Denny-Hwang/TENG_SLT/docs/IMG_1770.jpeg

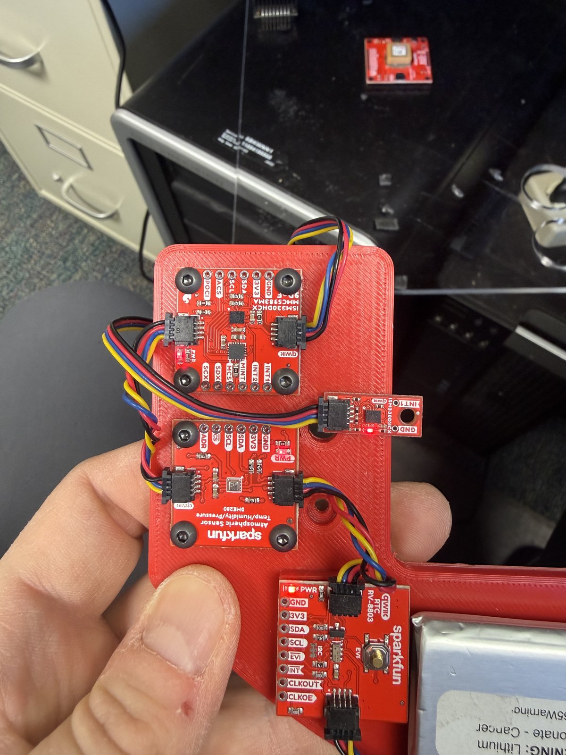
docs/IMG_1770.jpeg
