Denny-Hwang/TENG_SLT/docs/Ground_RFD900x.png

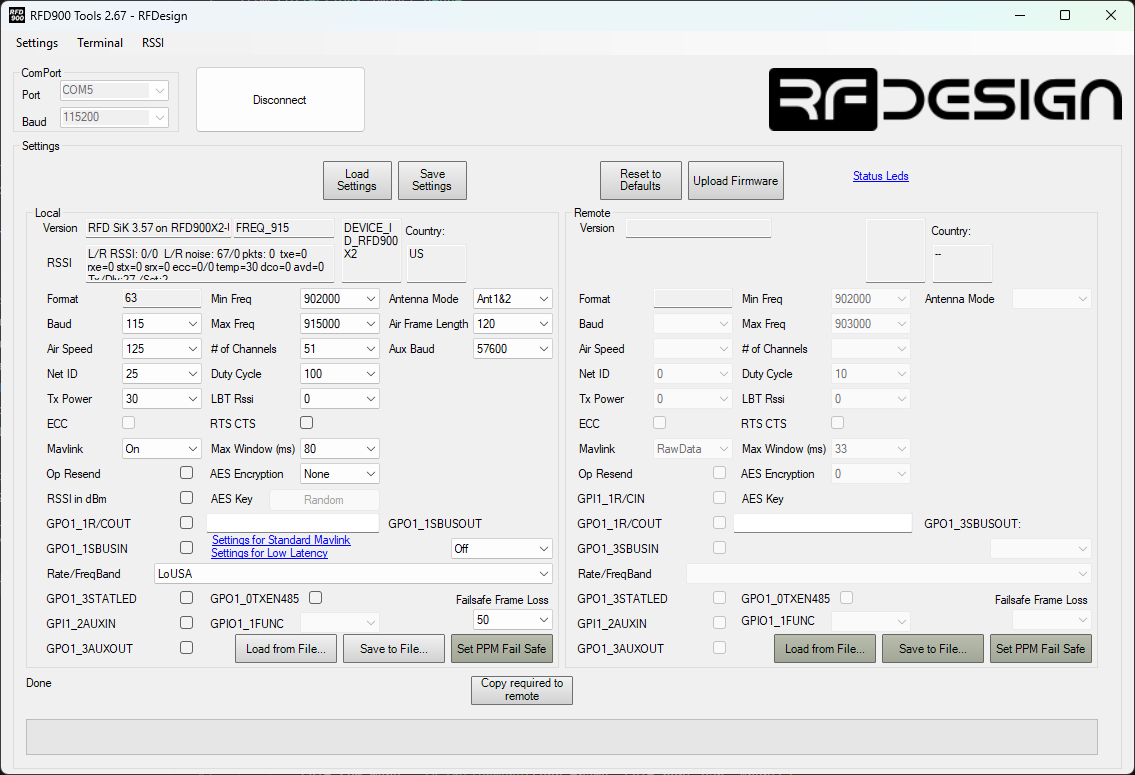
docs/Ground_RFD900x.png
