Denny-Hwang/TENG_SLT/docs/Screenshot 2026-04-22 175744.png

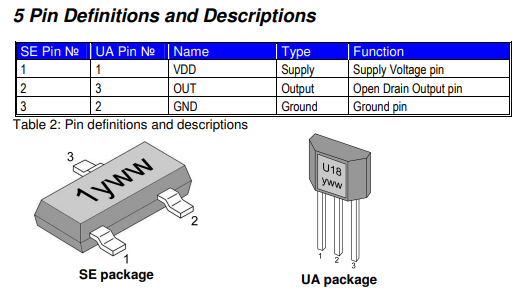
docs/Screenshot 2026-04-22 175744.png
