Denny-Hwang/TENG_SLT/docs/vertisea_system_diagram.png

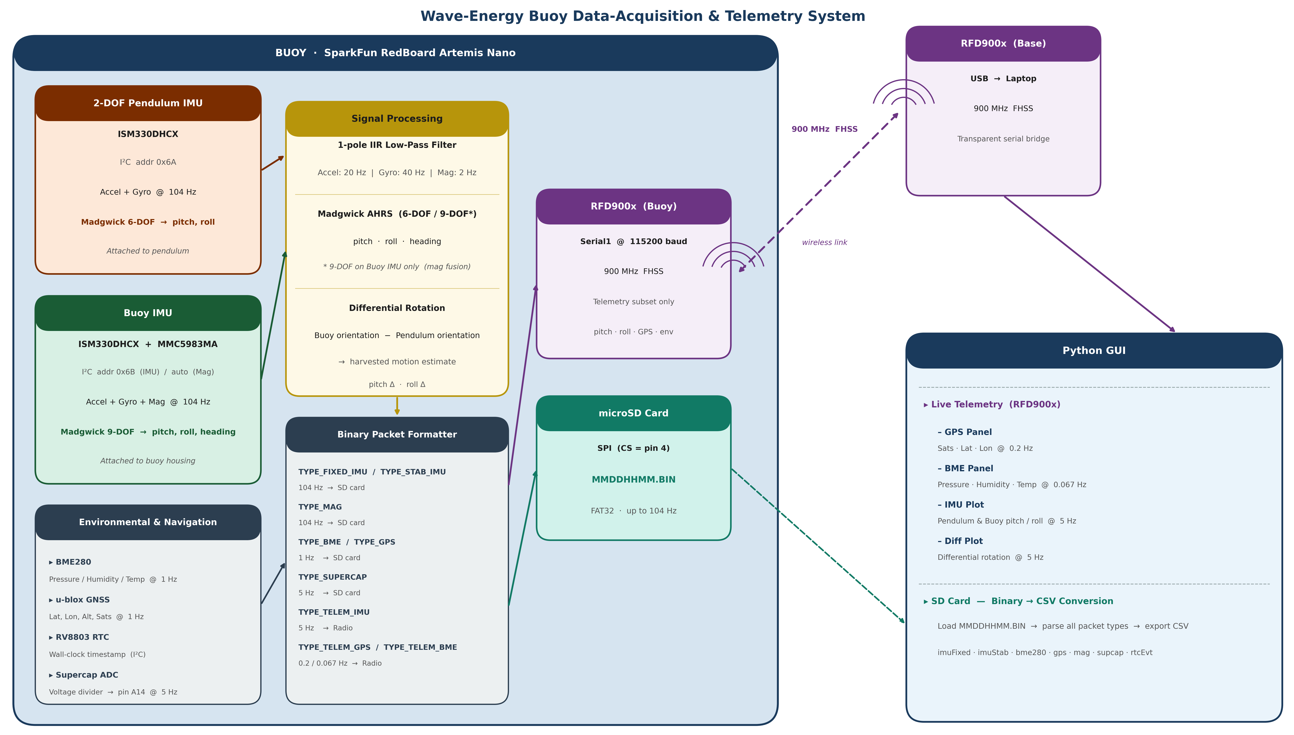
docs/vertisea_system_diagram.png
