Denny-Hwang/TENG_SLT/Calibration/accel_calibration_meas.txt

Fixed
X_bias = (1008 + -1001)/2 = 3.5
X_scale = (1008 - -1001)/2 = 1004.5

Y_bias = (982 + -1032)/2 = -25
Y_scale = (982 - -1032)/2 = 1007

Z_bias = (1009 + -989)/2 = 10
Z_scale = (1009 - -989)/2 = 999

Stab
X_bias = (998 + -1004)/2 = -3
X_scale = (998 - -1004)/2 = 1001

Y_bias =  (979 + -1009)/2 = -15
Y_scale = (979 - -1009)/2 = 994

Z_bias = (1026 + -981)/2 = 22.5
Z_scale = (1026 - -981)/2 = 1003.5
