Denny-Hwang/TENG_SLT/Calibration/calibration.xlsx

Sheet: Sheet1
min | max
-1005.5 | 998 | 1001.75 | -3.75
-1014 | 978.5 | 996.25 | -17.75
-978.5 | 1029.5 | 1004 | 25.5

Sheet: Sheet1 (2)
min | max
-1001.5 | 1006.5 | 1004 | 2.5
-1031.5 | 984 | 1007.75 | -23.75
-985 | 1008 | 996.5 | 11.5
