Denny-Hwang/TENG_SLT/docs/CHANGELOG_vertisea_explorer.py.md

# Explorer Changelog

## 2026-10-17 - Offline Tk explorer - [UNCONFIRMED]

Added standalone Toplevel explorer, paged native and aligned sheets with both
scrollbars, multi-table numeric selection, boot/source/time filters, shared-x
separate-axis plots and streamed CSV export. Worker-owned read-only handles keep
Tk responsive without sharing a live recorder handle. Active recorder guard,
rolling display and explicit estimated power avoid silent scientific claims.
Synthetic Tk tests cover resize, plots, export, invalid inputs and GUI launch.
