Denny-Hwang/TENG_SLT/tests/test_binary_protocol.py

#!/usr/bin/env python3
"""Round-trip tests for the VertiSea SD binary protocol.

WHY THIS EXISTS
---------------
`vertisea_plot_v7.py` is the *only* reader of the SD log format. Every packet layout is
duplicated by hand in two places — the packed structs in `VertiSea/VertiSea.ino` and the
`struct.unpack` format strings here — with nothing but discipline keeping them aligned.
A silent divergence corrupts every CSV produced from that point on, and the corruption is
not obvious: a wrong field width shifts subsequent columns into plausible-looking numbers.

So this file builds `.BIN` byte streams from the layouts documented in
`docs/binary_protocol.md`, feeds them through `parse_binary_file()`, and asserts the values
come back unchanged. It is a *writer* independent of the parser: if the parser's field
order or width drifts, the assertion fails.

WHAT IT DOES NOT PROVE
----------------------
That the firmware emits these bytes. Nothing here compiles or runs the sketch, so a change
made to `VertiSea.ino` alone will not fail these tests — they pin the parser against the
protocol document, not against the firmware. Issue 35 is the standing reminder that a
round-trip test proves the *transport* is right and says nothing about whether the chosen
types can hold real values: an int16 gyro field round-tripped perfectly and still wrapped
sign on hardware. Check a real log against physical expectations too.

USAGE
-----
    python3 tests/test_binary_protocol.py        # stdlib only, no pytest required
    python3 -m pytest tests/test_binary_protocol.py -q    # also works under pytest
"""

import csv
import os
import struct
import sys
import tempfile
import unittest

sys.path.insert(0, os.path.dirname(os.path.dirname(os.path.abspath(__file__))))

import vertisea_protocol as vs  # noqa: E402


# ---------------------------------------------------------------------------
# Record writers — independent of the parser, built from docs/binary_protocol.md
# ---------------------------------------------------------------------------

def record(pkt_type: int, ts_ms: int, payload: bytes) -> bytes:
    """The 5-byte common header (uint8 type + uint32 little-endian ms) plus payload."""
    return struct.pack('<BI', pkt_type, ts_ms) + payload


def imu_raw(ts_ms, fix_a, fix_g, stab_a, stab_g, interval_us) -> bytes:
    """0x12 — '<3h3i3h3iH', 38-byte payload."""
    return record(vs.TYPE_IMU_RAW, ts_ms,
                  struct.pack('<3h3i3h3iH', *fix_a, *fix_g, *stab_a, *stab_g, interval_us))


def current_block(ts_ms, span_ms, samples) -> bytes:
    """0x0E — uint16 span_ms, uint16 count, count x uint16. Variable length."""
    return record(vs.TYPE_CURRENT_BLOCK, ts_ms,
                  struct.pack('<HH', span_ms, len(samples))
                  + struct.pack(f'<{len(samples)}H', *samples))


def hall_edge(ts_ms, edges_us) -> bytes:
    """0x11 — uint8 count, count x uint32 micros(). Variable length."""
    return record(vs.TYPE_HALL_EDGE, ts_ms,
                  struct.pack('<B', len(edges_us))
                  + struct.pack(f'<{len(edges_us)}I', *edges_us))


def sys_health(ts_ms, loop_max_us=3000, sd_write_max_us=1200, sd_write_failures=0,
               sd_recoveries=0, hall_rejected=0, hall_lost=0,
               sd_queue_high_water=512, sd_overruns=0, flags=0) -> bytes:
    """0x15 — '<6I2HB', 29-byte payload."""
    return record(vs.TYPE_SYS_HEALTH, ts_ms,
                  struct.pack('<6I2HB', loop_max_us, sd_write_max_us,
                              sd_write_failures, sd_recoveries, hall_rejected,
                              hall_lost, sd_queue_high_water, sd_overruns, flags))


def current_cal(ts_ms, vref, adc_max, div_ratio, sens) -> bytes:
    return record(vs.TYPE_CURRENT_CAL, ts_ms,
                  struct.pack('<4f', vref, adc_max, div_ratio, sens))


def battery_cal(ts_ms, vref, adc_max, r_top, r_bottom, ratio) -> bytes:
    return record(vs.TYPE_BATTERY_CAL, ts_ms,
                  struct.pack('<5f', vref, adc_max, r_top, r_bottom, ratio))


# `data['errors']` mixes two different things: structural failures that stop the parse
# (truncated record, unknown type) and advisory warnings about an otherwise-fine log
# (no calibration record, so the derived column stays blank). Most tests care only about
# the former, so they assert on this filtered view rather than on an empty list.
_STRUCTURAL = ('Truncated', 'Unknown packet type', 'Skipped known-type')


def structural_errors(data: dict) -> list:
    return [e for e in data['errors'] if any(k in e for k in _STRUCTURAL)]


def parse_bytes(blob: bytes) -> dict:
    """Write `blob` to a temp .BIN and run the production parser over it."""
    fd, path = tempfile.mkstemp(suffix='.BIN')
    try:
        with os.fdopen(fd, 'wb') as f:
            f.write(blob)
        return vs.parse_binary_file(path)
    finally:
        os.unlink(path)


# ---------------------------------------------------------------------------


class TestFixedLayouts(unittest.TestCase):
    """Every fixed-size packet survives a write/parse round trip."""

    def test_imu_raw_round_trip(self):
        data = parse_bytes(imu_raw(
            12345,
            fix_a=(-1000, 2000, 980), fix_g=(-250000, 250000, 1),
            stab_a=(11, -22, 1001), stab_g=(7, -8, 9),
            interval_us=10780))
        self.assertEqual(data['errors'], [])
        self.assertEqual(len(data['imu_raw']), 1)
        r = data['imu_raw'][0]
        self.assertEqual(r['ts_ms'], 12345)
        self.assertEqual((r['fix_ax_mg'], r['fix_ay_mg'], r['fix_az_mg']), (-1000, 2000, 980))
        self.assertEqual((r['fix_gx_mdps'], r['fix_gy_mdps'], r['fix_gz_mdps']),
                         (-250000, 250000, 1))
        self.assertEqual((r['stab_ax_mg'], r['stab_ay_mg'], r['stab_az_mg']), (11, -22, 1001))
        self.assertEqual(r['interval_us'], 10780)

    def test_imu_raw_gyro_holds_full_scale(self):
        """Issue 35: at ISM_500dps the gyro reaches 500000 mdps, 15x the int16 range.

        An int32 field must carry it without wrapping sign. This is the regression that
        int16 passed structurally and failed on hardware.
        """
        full_scale = 500000
        data = parse_bytes(imu_raw(
            1, fix_a=(0, 0, 1000), fix_g=(full_scale, -full_scale, full_scale),
            stab_a=(0, 0, 1000), stab_g=(-full_scale, full_scale, -full_scale),
            interval_us=0))
        r = data['imu_raw'][0]
        self.assertEqual(r['fix_gx_mdps'], full_scale)
        self.assertEqual(r['fix_gy_mdps'], -full_scale)
        self.assertEqual(r['stab_gx_mdps'], -full_scale)

    def test_processed_imu_round_trip(self):
        payload = struct.pack('<9fH', 1.5, -2.5, 999.9, 0.1, 0.2, 0.3,
                              0.01, 0.02, 1.0, 9615)
        data = parse_bytes(record(vs.TYPE_FIXED_IMU, 7, payload)
                           + record(vs.TYPE_STAB_IMU, 8, payload))
        self.assertEqual(data['errors'], [])
        f = data['fixed_imu'][0]
        self.assertAlmostEqual(f['pitch'], 1.5, places=5)
        self.assertAlmostEqual(f['roll'], -2.5, places=5)
        self.assertAlmostEqual(f['heading'], 999.9, places=3)
        self.assertEqual(f['interval_us'], 9615)
        self.assertEqual(data['stab_imu'][0]['ts_ms'], 8)

    def test_rtc_event_year_offset(self):
        """Year is stored as an offset from 2000; the parser must add it back exactly once.

        Issue 28 was a double-add of 2000 producing years near 4074.
        """
        data = parse_bytes(record(vs.TYPE_RTC_EVENT, 100,
                                  struct.pack('<6B', 26, 9, 11, 17, 42, 7)))
        r = data['rtc_event'][0]
        self.assertEqual(r['year'], 2026)
        self.assertEqual((r['month'], r['day'], r['hour'], r['minute'], r['second']),
                         (9, 11, 17, 42, 7))

    def test_bme_gps_rpm_round_trip(self):
        blob = (record(vs.TYPE_BME, 1, struct.pack('<3f', 101325.0, 43.5, 21.25))
                + record(vs.TYPE_GPS, 2, struct.pack('<B', 9)
                         + struct.pack('<3f', 46.25, -119.5, 120.0))
                + record(vs.TYPE_RPM, 3, struct.pack('<H', 1987)))
        data = parse_bytes(blob)
        self.assertEqual(data['errors'], [])
        self.assertAlmostEqual(data['bme'][0]['pressure'], 101325.0, places=1)
        self.assertEqual(data['gps'][0]['satellites'], 9)
        self.assertAlmostEqual(data['gps'][0]['latitude'], 46.25, places=4)
        self.assertEqual(data['rpm'][0]['rpm'], 1987)

    def test_cal_packets_field_order(self):
        """The nine IMUCal floats must land in bias/scale/bias order, not shuffled."""
        vals = (1.0, 2.0, 3.0, 1004.5, 1007.0, 999.0, -2.36, -396.8, -192.5)
        data = parse_bytes(record(vs.TYPE_FIXED_CAL, 5, struct.pack('<9f', *vals)))
        c = data['fixed_cal'][0]
        self.assertAlmostEqual(c['accel_bias_x'], 1.0, places=5)
        self.assertAlmostEqual(c['accel_scale_x'], 1004.5, places=3)
        # gyro_bias is in MILLIdegrees/s, not deg/s — see Issue 42.
        self.assertAlmostEqual(c['gyro_bias_y'], -396.8, places=3)
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
