Denny-Hwang/TENG_SLT/(commit log)

2026-09-11 Initial import of VertiSea
    [calibration.xlsx]
2026-09-11 Repo review: fix doc drift, correct gyro_bias units, prune captured log
    Full-repository review. Behavioural findings were filed as issues rather
    than changed blind, because they need hardware to verify; only provably
    wrong documentation and one redundant capture file were changed.
    README: the operating instructions described a build that is not in the
    repo. It stated USB_TELEM 1 / TELEM_ENABLE 1 while the source has both 0,
    so anyone following it would flash an SD-only build, connect the ground
    station, and see a blank GUI with no documented reason. Also rewrote the
    hardware table (A14 is the current sensor wired directly, not a
    supercapacitor divider; added A15 battery divider and the Hall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
    [VertiSea.ino]
2026-09-11 Split parser from GUI, add protocol tests, fix Issues 43-51
    Housekeeping requested by the reviewer, then the findings from the previous
    commit that could be fixed without hardware.
    Housekeeping
    ------------
    - docs/IMG_1770.jpeg: 4032x3024 iPhone original -> 1600 px long edge,
    EXIF orientation baked in, 2.5 MB -> 302 kB (88% smaller). It was the
    largest file in the repo. Board silkscreen and wiring are still legible.
    - archived/: new folder for material kept for the record but not part of
    the system. Moved AI_Agent_Project_Documentation_Guide.md (a generic
    methodology document that never mentions VertiSea) and
    CHANGELOG_parse_vertisea_log_v4.m.md (changelog for a parser deleted in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
    [VertiSea.ino, test_binary_protocol.py, vertisea_plot_v7.py, vertisea_protocol.py]
2026-09-11 Robust long-duration logging and a real High-Resolution filter
    Two reported faults: the heartbeat LED stops blinking or sticks on
    during logging (apparently influenced by the measurement signal), and
    the current post-processing does not resemble a Keysight scope in
    High-Resolution mode.
    1. LED / logging robustness
    ---------------------------
    The LED toggles in the LAST block of loop(), so a frozen LED means a
    pass did not complete. Four independent defects could produce that and
    nothing recorded enough to tell them apart.
    - digitalRead() on an OUTPUT pad: the heartbeat did
    digitalWrite(LED, !digitalRead(LED)). On Apollo3 an OUTPUT pad may
    have its input buffer disabled, so digitalRead(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
2026-09-11 Move the vendored Madgwick into the sketch folder so it is compiled
    Answering "does the repository name matter to the Arduino code?": the repo
    name does not, but checking it surfaced a real build defect.
    Arduino only requires that a .ino's immediate parent folder share its name,
    which VertiSea/VertiSea.ino satisfies; the repository name is the
    grandparent and is irrelevant. But VertiSea/ contained only the .ino, while
    #include "MadgwickAHRS.h" expected a header that lived in a sibling
    Madgwick/src/ directory.
    A quoted include searches the including file's own directory first, then
    the compiler's -I paths. arduino-builder's paths cover the sketch folder,
    core, variant and sketchbook librari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
2026-09-11 Refuse to build on Apollo3 core 2.x: micros() in the Hall ISR panics mbed
    Confirmed on hardware. Core 1.x is a bare Arduino core where micros() is a
    timer read; core 2.x is mbed-OS based and forbids RTOS primitives in
    interrupt context, and its micros() takes a mutex. hallISR() calls
    micros() first thing, so on 2.x the board panics on the FIRST Hall edge,
    about a second into loop():
    Error Message: Mutex: 0x100033BC, Not allowed in ISR context
    What made this expensive is that it does not look like a crash. The .BIN
    contains exactly 196 bytes -- the boot records flushed in setup(), with
    the panic landing before the first 5 s flush. No telemetry is ever sent.
    And the LED keeps blinking at ~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
    [VertiSea.ino]
2026-09-11 Stop the USB_DEBUG line printing counters the health block just zeroed
    Field output showed maxWriteUs=0 on every 1 Hz debug line -- which is
    exactly the number someone reads that line to see.
    Both the health-record block and the USB_DEBUG print fire at 1 Hz, and
    the health block runs earlier in loop(). It resets sdServiceMaxUs and
    loopMaxUs after writing the record, so the debug print always read zeros.
    Introduced with the health record earlier today.
    The reported values are now stashed before the reset, so the console line
    and the SD record agree. Also adds loopUs= to the debug line: nominal is
    ~2700, and a much larger value means loop() is not achieving its rate,
    which starves every gate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
    [VertiSea.ino]
2026-09-11 Record the core 2.x printf regression and the 1.2.1 confirmation
    Two additions to Issue 59 from the hardware session.
    Core 2.x links a reduced printf that ignores width and zero-pad flags, so
    every snprintf("%02d") / "%05lu" in the filename and timestamp paths
    silently degraded: 9111614.BIN instead of 09111614.BIN, LOG4.BIN instead
    of LOG00004.BIN, 2026-9-11 instead of 2026-09-11. That breaks the
    documented MMDDHHMM.BIN 8.3 convention and anything sorting or parsing on
    it -- another 2.x divergence that compiles cleanly and only shows at run
    time.
    And the confirmation: on core 1.2.1 the same board and sketch regained
    zero-padded filenames, stopped leaking binary telemetry into the
    USB_DEBUG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
2026-09-11 Decimate like the scope, and stop rewriting ADC saturation as noise
    Three defects behind the report that the current filter "isn't removing
    noise", found on the field capture 09111632_currentFast.csv. Only one of
    them was a filter problem.
    reject_full_scale() rewrote every sample at the rail with a neighbour
    median. That is right for an isolated glitch and wrong for a run: a run
    of rail samples is the ADC truthfully reporting it is out of range, and
    a replacement drawn from the bracketing samples is systematically low.
    The bias then went into a mean-preserving boxcar, which propagated it
    across the window - the filtered line landing in the middle of the raw
    band instead of tracking it. It n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
    [current_filter_test.py, vertisea_plot_v7.py]
2026-09-11 Stop reporting a backwards micros() step as a 71-minute loop stall
    A real log reported loop_max_us = 4 294 967 295 - UINT32_MAX - and the
    parser's health post-pass turned that into "4294967 ms loop stall, most
    likely an I2C stall". There was no stall; the same log's other records
    peak at 48 ms.
    micros() on Apollo3 is not strictly monotonic. Two adjacent calls can
    return n then n-1 when a read straddles the STIMER clock-domain
    boundary. nowUs - lastLoopEntryUs is correct across the genuine ~71.6
    min rollover, where unsigned subtraction yields a small delta, but turns
    a one-microsecond backward step into 4 294 967 295 us - and loopMaxUs
    max-holds it for the whole second. sdServiceMaxUs around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
    [VertiSea.ino, test_binary_protocol.py, vertisea_protocol.py]
2026-09-12 Degrade instead of halting on SD faults; read the bench test honestly
    Two findings from a bench capture with supplies on both ADC channels,
    and a firmware policy change the user's workflow forced.
    The current channel read a floating input for 22 s and then a hard
    zero; it never saw the 1.2 V that was applied. The battery channel in
    the same log read 3.28 V for 3.30 V through the divider, so the ADC,
    the reference and the arithmetic are all working in that very capture,
    and docs/adc_calibration.md records A14 tracking a DMM to 1.5 % on
    this exact code path. The pad identities are now verified against the
    core 1.2.1 Artemis Nano variant table - A14 is pad 35 / SE7, A15 is
    pad 32 / SE4 - and s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
2026-09-14 Move deployment flags to a git-ignored config_local.h
    git pull refused to merge over VertiSea.ino for the second time in a
    week, both times because the operator's session flags - TELEM_ENABLE,
    USB_TELEM, USB_DEBUG - were edits to the committed #define lines. The
    flags describe the deployment, not the source, and each conflict landed
    at the moment a fix was needed on the same file.
    Every deployment flag is now an #ifndef default, and the sketch
    includes VertiSea/config_local.h first when it exists, via
    __has_include guarded for a pre-GCC-5 preprocessor (core 1.2.1 ships
    GCC 8). config_local.h is git-ignored; config_local.h.example is
    committed with the three standard sessions ready to uncomm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
    [VertiSea.ino]
2026-09-14 Fix build: declare the timer-anomaly globals above their first user
    VertiSea.ino:1020: error: 'TIMING_MAX_PLAUSIBLE_US' was not declared
    VertiSea.ino:1021: error: 'timerAnomaly' was not declared
    The 2026-09-11 timer guard put both next to HEALTH_FLAG_TIMER_ANOM and
    loopMaxUs around line 1330, below sdServiceOneSector() at ~1020 - the
    first function to use them. The Arduino preprocessor forward-declares
    functions only, never variables, so a definition further down the file
    is invisible to code above it. That commit said it was not compiled
    here; this is what that cost.
    Both now sit just above #if SD_BUFFERED_WRITE in the SD globals block,
    and deliberately outside that guard: loop()'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
    [VertiSea.ino]
2026-09-15 Report the absolute ADC level, and range-check the battery channel
    A bench calibration - supply on each ADC pin, both confirmed with a
    meter - came back looking wrong in the log. Three places where the
    tooling could not tell a calibration check from a deployment log.
    current_filter_test.py removed the idle offset from a flat capture,
    where the offset IS the signal, and reported ~0 mA. Working as
    designed, which is the problem: nothing said which kind of record it
    thought it had. The INPUT block now prints the absolute level - mean
    counts, mean mA, sd, median - before any baseline removal, with the
    counts-per-volt relation beside it, because _currentFast.csv stores raw
    counts and every later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
    [current_filter_test.py, test_binary_protocol.py, vertisea_protocol.py]
2026-09-15 Measure the ADC channel interaction instead of arguing about it
    Bench report: each supply alone reads correctly, both together and
    neither does, concluded as "the MCU cannot measure voltage and current
    at the same time".
    That is disproved by this project's own data. docs/adc_calibration.md
    records three 120 s captures with both channels driven simultaneously
    from separate bench supplies at different voltages, 60 000 samples per
    channel per run, and every channel tracked its own DMM value to within
    1.4 % - A14 at 1864 mV while A15 sat at 1217 mV, and so on. The Apollo3
    ADC is one SAR behind a mux and analogRead() reconfigures the slot per
    call: that is time-multiplexing, not a restriction. S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
    [test_binary_protocol.py, vertisea_protocol.py]
2026-09-15 Withdraw the divider finding; report the implied divider-input voltage
    The resistors were measured: 98.9k and 98.8k, a ratio of 2.001 either
    way round against the firmware's 1.998 - within 0.15%. There is no
    divider-constant error, so Issue 68 is withdrawn. It solved the right
    equation for the wrong unknown: I treated the 3.30 V source as the
    measurement and the ratio as the assumption, when it was the other way
    round.
    With the ratio confirmed, the same counts say the divider input really
    was at 3.60 V rather than the 3.30 V that was set. The grounds are
    shared, which also removes the ground-loop hypothesis this issue opened
    with.
    What is left fits a dual-output bench supply in SERIES or T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
    [vertisea_protocol.py]
2026-09-15 Close the channel-interaction issue; the battery divider is open
    Grounding fixed it, and the 18:03 capture proves it cleanly: the
    battery channel sat pinned at 16383 for five seconds before the current
    channel was energised at all, and when the current channel came up it
    read 9130 counts = 1.099 V = 109.9 mA against 1.100 V applied, correct
    to 0.1 %, and stayed correct while the battery channel stayed pinned.
    Two faults that no longer move together are two independent channels.
    My SERIES/TRACKING supply hypothesis was wrong, for the same reason the
    withdrawn Issue 68 was: I kept reaching for an explanation that made
    both channels one system when the evidence only ever showed a shared
    return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
    [vertisea_protocol.py]
2026-09-15 Record the resolution: Issue 69 closed, 70 and 71 opened
    The previous commit's message described this, but a broken conditional
    in the edit script left IDENTIFIED_ISSUES.md untouched - so the parser
    change shipped without the record explaining it, and the commit message
    claimed work the diff did not contain.
    Issue 69 is closed with the 18:03 capture as proof, and keeps the
    disproof of the MCU claim on record. It also records the two wrong
    hypotheses I proposed - a ground loop, then a SERIES/TRACKING supply
    whose arithmetic fit the 4.40 V saturation neatly - and what they had
    in common with the withdrawn Issue 68: each explained the two channels
    as one coupled system when the evidence only e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
2026-09-15 Close the last two bench issues: wrong injection point, and a knob
    Issue 70: the 3.3 V was being applied at the wrong node, so the divider
    was never in circuit and the pad saw the whole source. That is the
    third row of the issue's own table, which I listed as a matching
    alternative while leading on an open R_bottom or an open ground return.
    Both produce an identical pinned reading and the log cannot separate
    them - but where the source is landing is the cheaper thing to check,
    so the saturation warning now tells the reader to check that first and
    only then reach for the meter.
    Issue 71: the +23.9 % excursion on a fixed 1.100 V input was the supply
    knob being turned. The channel was tracking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
    [vertisea_protocol.py]
2026-09-15 Flag high divider source impedance; battery reads 17.6 percent low
    The 18:18 capture is the first with both channels live and steady at
    the same time - A14 around 9060 with A15 at 11265 - and neither moves
    when the other is switched. Issue 69 is confirmed closed on evidence
    rather than on the absence of a symptom.
    The battery level is wrong by a clean fixed fraction: 11265 counts
    against 13666 expected, -17.6 %, putting the divider input at 2.720 V
    instead of 3.300 V. That is equivalent to about 232 kohm shunting the
    pad to ground. Two candidates, and one meter reading at the pad
    separates them: a real parallel path on the board, or the ADC failing
    to charge through the divider.
    The second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
    [vertisea_protocol.py]
2026-09-15 Diagnose the battery deficit: the ADC cannot charge through 49.4 kohm
    Meter on the ADC pad reads 1.65 V while the log reports 1.36 V. The
    divider is correct and the ADC is the thing that is wrong - it is not
    converting the voltage that is actually present. A 49.4 kohm Thevenin
    source cannot charge the Apollo3 SAR's sample capacitor inside one
    sample window, so every conversion lands 17.6 % short.
    The fix is 0.1 uF from the ADC pad to board GND: about 0.01 % droop per
    conversion against a 10 pF sample cap, and 4.94 ms recovery against a
    1 s sampling interval. Lowering the divider resistances also works but
    trades quiescent draw - 10k/10k would pull 165 uA against the present
    16.7 uA, roughly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
    [VertiSea.ino, vertisea_protocol.py]
2026-09-15 Confirm the capacitor fix by A/B, and record the first live SD recovery
    The 0.1 uF was held against the pins mid-run, which gives a controlled
    A/B in one session with the wiring untouched:
    no capacitor 11 270 counts 2.722 V at the divider input -17.5 %
    0.1 uF at the pad 13 399 counts 3.236 V -1.95 %
    removed again 11 264 counts 2.720 V -17.6 %
    89 % of the deficit recovered, and the error returns the moment the
    capacitor comes off. The mechanism is settled: the Apollo3 SAR could not
    charge its sample capacitor through the 49.4 kohm divider. Fit it
    permanently; 1 uF is safer still - 0.001 % droop, 49 ms recovery, twenty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
    [vertisea_protocol.py]
2026-09-15 Size the battery pad capacitor deliberately: 2.2 uF ceramic
    2.2 uF is not just acceptable, it is the better choice, and the reason
    is not charge storage - every candidate from 0.1 uF up droops far below
    the noise floor against a ~10 pF sample capacitor. It is aliasing. The
    battery channel samples at 1 Hz, so Nyquist is 0.5 Hz, and 0.1 uF
    leaves the RC corner at 32 Hz: everything between folds into the record.
    2.2 uF pulls the corner to 1.46 Hz and removes most of it, while still
    settling in 544 ms against a 1 s interval.
    The upper bound is real though. 10 uF puts the corner under Nyquist,
    which sounds ideal, but takes 2.5 s to settle and would smear the
    load-sag transient the battery channe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
    [vertisea_protocol.py]
2026-09-15 Rule out the aluminium electrolytic, and say why a meter would not catch it
    An aluminium 2.2 uF works on the bench and is the wrong part to leave
    fitted. Its leakage is a load on a 49.4 kohm source: 1 nA costs 0.01 %,
    500 nA costs 1.5 %, and the 3 uA such a datasheet typically permits
    costs 8.25 %. At 1.65 V on a part rated for tens of volts the real
    figure is usually far better than the limit, so a bench check will
    probably pass - which is the trap. Electrolytic leakage roughly doubles
    every 10 C and grows as the oxide deforms at low bias, so it becomes a
    scale error that moves with temperature and age. That is the worst
    possible shape for a measurement, and it is the same class of quietly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
2026-09-15 2.2 uF fitted: 16.9 to 2.4 percent, and the meter was measuring itself
    Source 3.290 V, meter on the pad 1.636 V. The meter was reading its own
    loading: 10 Mohm in parallel with the 98.8 kohm bottom leg makes it
    97.833 kohm and drops the pad from 1.6442 V to 1.6361 V - the 1.636 V
    seen, to within a millivolt. On a 49.4 kohm node whatever you attach to
    look at it becomes part of the circuit, which is the same lesson as the
    capacitor. I had been treating the pad reading as ground truth and
    telling the user to do the same; the honest reference is source divided
    by ratio, since the source is low-impedance and metering it costs
    nothing. docs/adc_calibration.md now says that.
    Against 13624 counts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
2026-09-18 Measure long-run log size, propose 30-minute rotation, fix the RTC anchor
    Asked how long the firmware can log continuously and whether the result
    is a sensible size on Windows. Measured on a hardware log rather than
    estimated: 6004 B/s, so 22 MB per hour and 520 MB per day. IMU_RAW is
    70 percent of that at 98 Hz, the 800 Hz current 28 percent.
    The card and the download are not the problem. The tooling is. The
    parser holds 46x the file in RAM - 13.4 MB for a 293 KB log, so 1 GB
    per hour and 24 GB per day - and _currentFast.csv passes Excel's row
    limit after 22 minutes at 795 rows per second. A one-day file cannot be
    parsed on any laptop.
    Proposal in POTENTIAL_UPGRADES.md U26: rotate into 30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
    [VertiSea.ino]
2026-09-18 Survive damaged bytes in the parser; add opt-in clean-close to firmware
    Asked whether a power cut can lose raw data, with data integrity as the
    first priority. Two findings, one fixed here and one bounded.
    The parser was the larger loss. The SD format has no sync marker and no
    CRC, and on a byte that was not a record type parse_binary_file()
    stopped - so one damaged sector at byte 1 000 000 of a 520 MB day-long
    log discarded 99.8 % of the data physically on the card. A damaged
    count in a CURRENT_BLOCK or HALL_EDGE was honoured as written and could
    skip kilobytes or run off the end. The parser now resynchronises: on an
    unknown type, or a count the firmware could never write (> 100 samples,
    >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
    [VertiSea.ino, test_binary_protocol.py, vertisea_protocol.py]
2026-09-18 Name the type byte when resync finds nothing; fix the test gate
    The previous commit (51b4c28) said "45 protocol tests pass". That was
    false: one test was failing when it was committed. The gate was
    `python3 tests/... | grep -E "^Ran|^OK|FAILED"`, and grep exits 0 when
    it matches the word FAILED, so the && chain went on to commit. The
    claim in that message should be read as wrong; this commit is the one
    where the suite is green, verified on the test runner's own exit status.
    The failing case was the parser's "no further valid record; stopping"
    message, which after the EOF-fit fix was correctly chosen but did not
    name the offending type byte the way the "skipped N bytes" message does.
    Both DA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
    [vertisea_protocol.py]
2026-09-18 Rotate the log every 5 minutes of uptime into a folder per day
    Implements U26 as the operator decided it: 5 minutes rather than the
    proposed 30, because a 5-minute _currentFast.csv is about 240 000 rows
    and opens in Excel, and counted from boot rather than aligned to the
    wall clock, because boot is the natural origin of the first interval
    and round filenames were never the point. SD_ROTATE_MINUTES 5 is the
    committed default; 0 restores one file per boot.
    Firmware. sdRotateIfDue() runs in the flush slot, right after a flush,
    so the seam costs one extra sync where a stall is already tolerated.
    It flushes the RAM queue, closes the file - a full sync, so the old
    file is complete from that insta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
    [VertiSea.ino, test_binary_protocol.py, vertisea_protocol.py]
